shadowpho/Chalk-Bot/README

Chalk robot.

--Root\
	Docs\
	Code\
	Hardware\
	Software\
