shadowpho/Chalk-Bot/Docs/Presentation/Final1.pptx

ECE 445 Group 1
December 2, 2011
George Karavaev – Alex Suchko

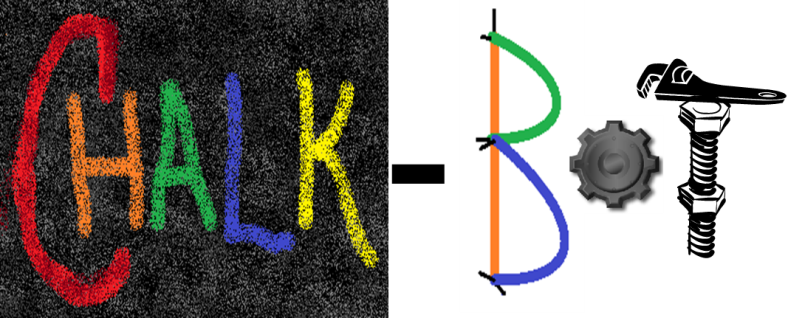
[picture p21: figure]

## Introduction

- ChalkBot is a semi-autonomous chalk drawing system.
- Produces vector graphics.
- Uses common, off the shelf sidewalk chalk.

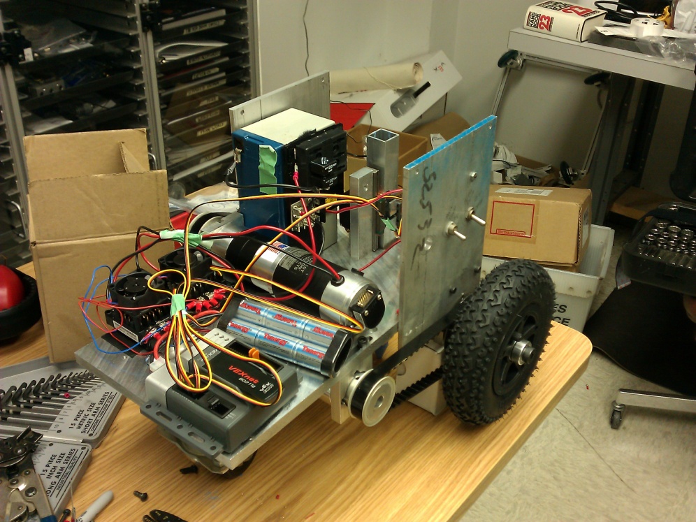
[picture p22: figure]

## Outline

- Mechanical Platform
  - GoBot Base and Chalk Feed
- Electronics System
  - Overview
  - Power Supply Subsystem
  - Dynamics Control Subsystem
  - High Level Control
- Software
  - Reset Sequencing and Supervision
  - Dynamics and Body Control
  - High Level Interface and Directive Control

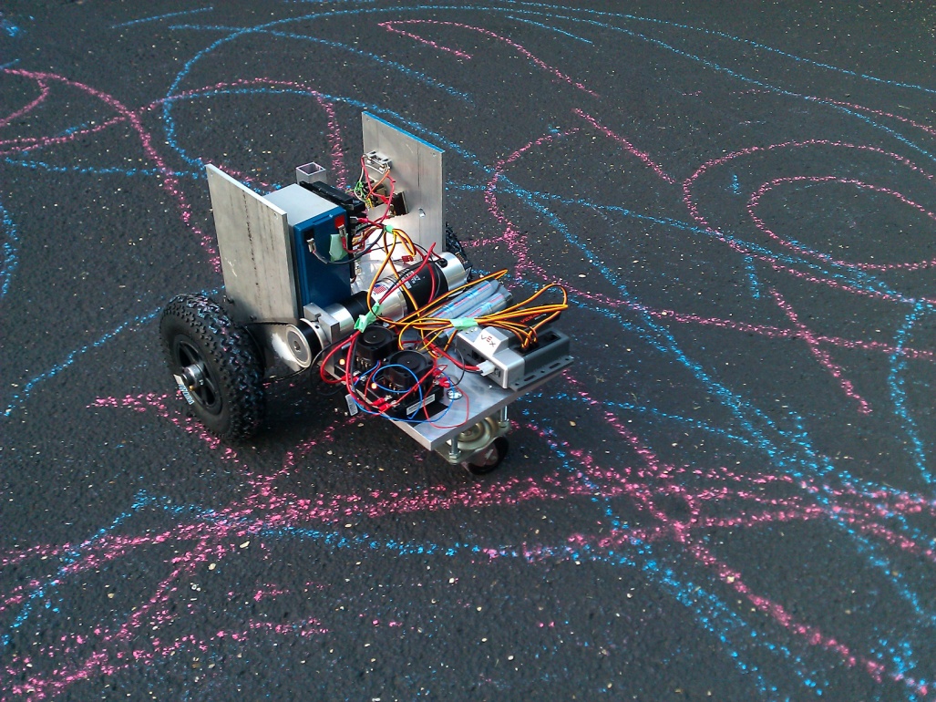
[picture p23: figure]

## Mechanical Platform

## Mechanical Platform\\ GoBot Base and Chalk Feed

- Two brushed drive motors, coupled to rear drive tires via synchronous belt.
- Forward idler ‘caster’ wheel.
- Rear mounted chalk feed mechanism, actuated by two positioning servo-motors.
- One 12VDC nominal sealed lead-acid battery.

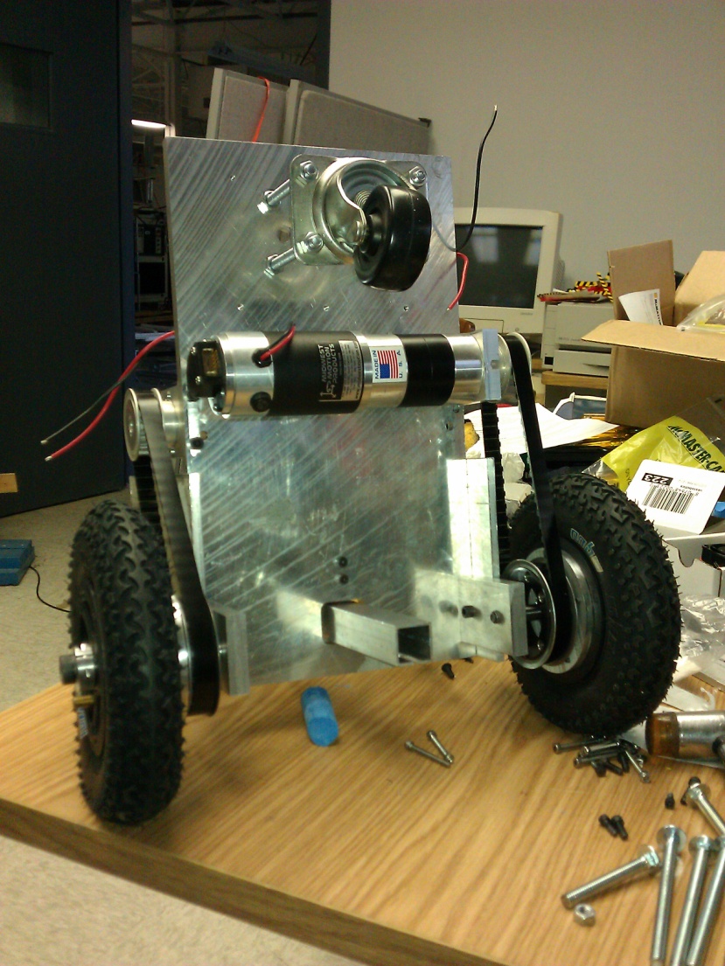
[picture p24: figure]

## Electronics System\\ Overview

## Special Thanks\\

- Mark Smart
- Skot Wiedmann
- Dan Mast
- Adam Suchko
- Mikhail Karavaev
- Kaitlin Minogue
- Jane Tu
- Tom Engibous (TI)

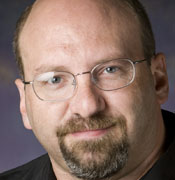
[picture p25: figure]
Mark Wayne Smart
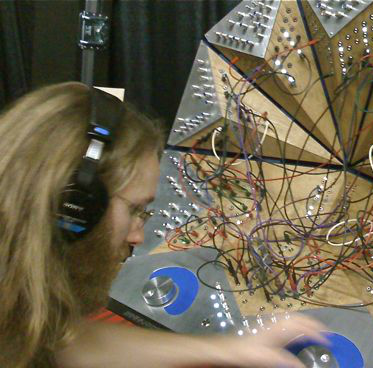
[picture p26: figure]
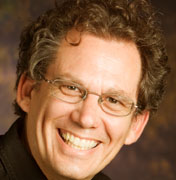
[picture p27: figure]
Daniel E. Mast
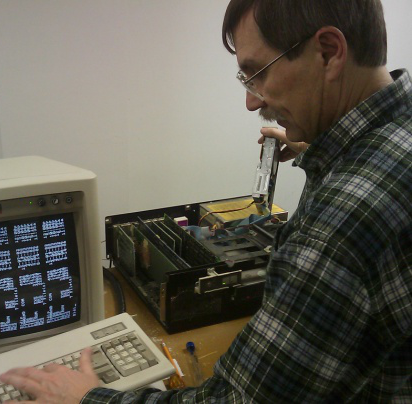
[picture p28: figure]
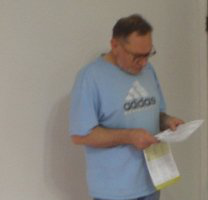
[picture p29: figure]
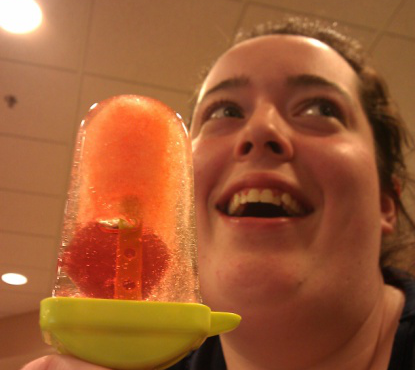
[picture p30: figure]
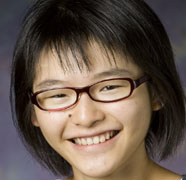
[picture p31: figure]
Jane S. Tu
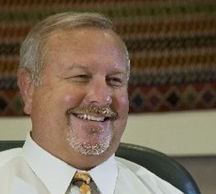
[picture p32: figure]

From top left: University of Illinois, TJ for Califaudio, University of Illinois, Alex Suchko, George Karavaev, Alex Suchko, University of Illinois, Brandon Wade for The Chronicle
