shadowpho/Chalk-Bot/Docs/Presentation/Mock1.pptx

ECE 445 Group 1
November 7, 2011
George Karavaev – Alex Suchko

don’t forget to credit Kaitlin for the ChalkBot logo


## Introduction

- ChalkBot is a semi-autonomous chalk drawing system.
- Produces vector graphics.
- Uses common, off the shelf sidewalk chalk.


## Outline

- Mechanical Platform
  - GoBot Base and Chalk Feed
- Electronics System
  - Overview
  - Power Supply Subsystem
  - Dynamics Control Subsystem
  - High Level Control
- Software
  - Reset Sequencing and Supervision
  - Dynamics and Body Control
  - High Level Interface and Directive Control


## Mechanical Platform\\ GoBot Base and Chalk Feed

- Two brushed drive motors, coupled to rear drive tires via synchronous belt.
- Forward idler ‘caster’ wheel.
- Rear mounted chalk feed mechanism, actuated by two positioning servo-motors.
- One 12VDC nominal sealed lead-acid battery.


## Electronics System\\ Overview
