shadowpho/Chalk-Bot/Docs/DesignReview/dtsheets/cb01_typical.png

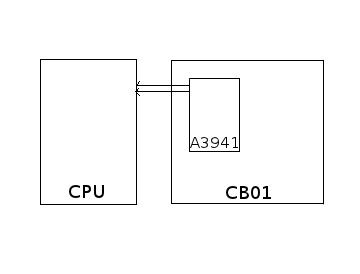
Docs/DesignReview/dtsheets/cb01_typical.png
