shadowpho/Chalk-Bot/Docs/DesignReview/ece445_general.png

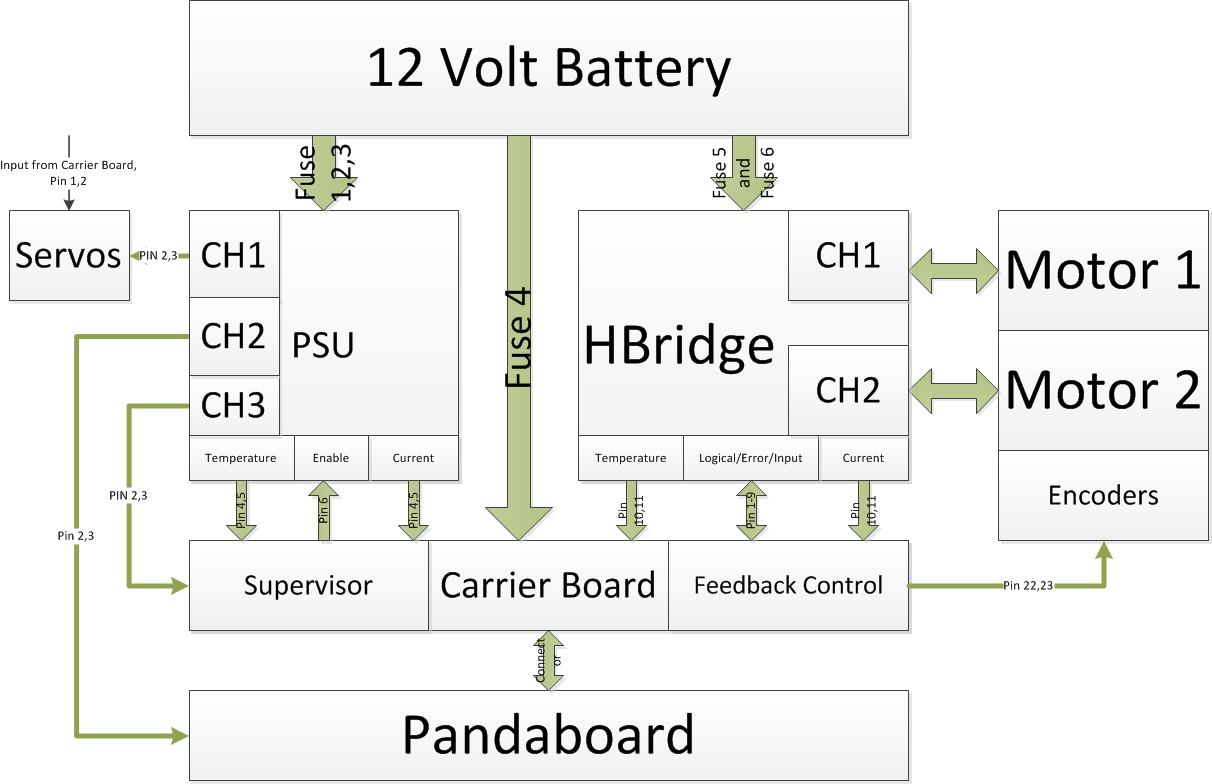
Docs/DesignReview/ece445_general.png
