shadowpho/Chalk-Bot/Docs/ProgressReport/ECE 445 Carrier board milling.jpg

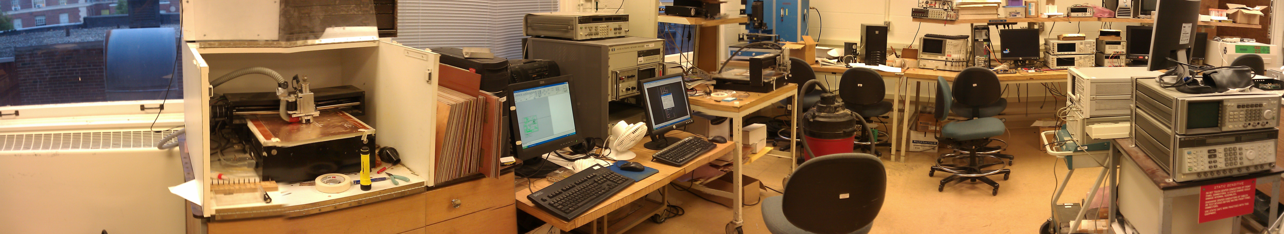
Docs/ProgressReport/ECE 445 Carrier board milling.jpg
