shadowpho/Chalk-Bot/Docs/ProgressReport/ECE 445 Lab 10_25_2011.jpg

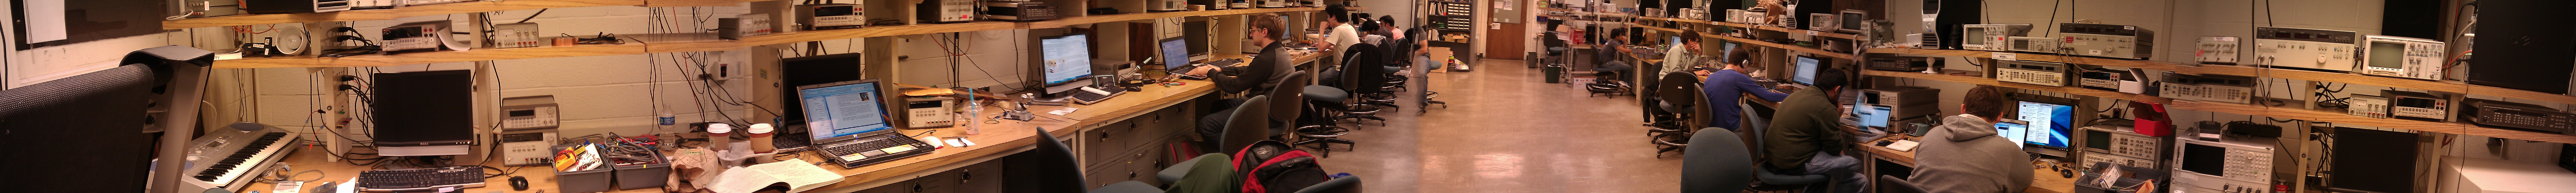
Docs/ProgressReport/ECE 445 Lab 10_25_2011.jpg
