shadowpho/Chalk-Bot/Docs/BOM_1.xlsx

Type | Value | Package | Quantity | Orderable P/N
capacitor | 0.1 uF | 603 | 5
capacitor | 0.1 uF | 1206 | 4
capacitor | 1.0 uF | 603 | 2
capacitor | 1.0 uF | 1206 | 2
capacitor | 5.0 uF | 1206 | 1
capacitor | 150 pF | 603 | 1
capacitor | 22 uF | CAP_POLPTH2 | 3 |  | c special
capacitor | 22 uF | 1206 | 1
capacitor | 2.2 uF | 603 | 3
capacitor | 3.6 pF | 603 | 1
current_sensor | INA226 | PSOP-10 | 2
inductor | NR10050T220M | NR10050 | 1
ldo | MIC5235 | SOT23-5 | 1
led |  | 805 | 2
nfet | IRFML8244 | SOT23 | 1
pfet | IRF9317 | SOIC8 | 1
pin_header | 68000-216HLF |  | 2
resistor | 0 ohm | 805 | 4
resistor | 1 ohm | 603 | 4
resistor | 1.3 kohm | 805 | 1
resistor | 10 kohm | 805 | 1 | 1792016
resistor | 150 kohm | 805 | 1
resistor | 19.62 kohm | 805 | 1 | 1753437
resistor | 3.74 kohm | 805 | 2
resistor | 10 mohm | 805 | 1
resistor | 40 mohm | 1206 | 1
resistor | 5.1 kohm | 805 | 6
resistor | 30 kohm | 805 | 1
screw_terminals | 1792016 |  | 3
smps | NCP3155A | SOIC8 | 1
socket | 1753437 |  | 3
temperature_sensor | TMP100 | PSOP-6 | 1
bridge_driver | A3941 | TSOP28 | 1
nfet | STP60N3LH5 | TO-220 | 4 |  | avnet
connector | 7693K-ND |  | 2
