shadowpho/Chalk-Bot/Software/motion/boards/ek-lm4f232/motion/flashstore.c

//*****************************************************************************
//
// flashstore.c - Data logger module to handle storage in flash.
//
// Copyright (c) 2011 Texas Instruments Incorporated.  All rights reserved.
// Software License Agreement
// 
// Texas Instruments (TI) is supplying this software for use solely and
// exclusively on TI's microcontroller products. The software is owned by
// TI and/or its suppliers, and is protected under applicable copyright
// laws. You may not combine this software with "viral" open-source
// software in order to form a larger program.
// 
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
// This is part of revision 8049 of the EK-LM4F232 Firmware Package.
//
//*****************************************************************************

#include <string.h>
#include "inc/hw_types.h"
#include "driverlib/debug.h"
#include "driverlib/flash.h"
#include "utils/ustdlib.h"
#include "motion.h"                 // prior to 11/10/2011, was qs-logger.h
#include "usbstick.h"
#include "flashstore.h"

//*****************************************************************************
//
// This module manages the storage of data logger data into flash memory.
//
//*****************************************************************************

//*****************************************************************************
//
// Define the beginning and end of the flash storage area.  You must make sure
// that this area is well clear of any space occupied by the application
// binary, and that this space is not used for any other purpose.
// The start and end addresses must be 1K aligned.  The end address is
// exclusive - it is 1 value greater than the last valid location used for
// storage.
//
//*****************************************************************************
#define FLASH_STORE_START_ADDR 0x20000
#define FLASH_STORE_END_ADDR 0x40000

//*****************************************************************************
//
// The next address in flash, that will be used for storing a data record.
//
//*****************************************************************************
static unsigned long g_ulStoreAddr;

//*****************************************************************************
//
// A buffer used to assemble a complete record of data prior to storing it
// in the flash.
//
//*****************************************************************************
static unsigned long g_ulRecordBuf[32];

//*****************************************************************************
//
// Initializes the flash storage. This is a stub because there is nothing
// special to do.
//
//*****************************************************************************
void
FlashStoreInit(void)
{
}

//*****************************************************************************
//
// Saves data records that are stored in the flash to an externally connected
// USB memory storage device (USB stick).
// The flash memory is scanned for the presence of store data records.  When
// records are found they are written in CSV format to the USB stick.  This
// function assumes a non-corrupted storage area, and that any records, once
// found, are contiguous with all stored records.  It will find the oldest
// record and start with that when storing.
//
//*****************************************************************************
int
FlashStoreSave(void)
{
    unsigned long ulAddr;
    unsigned long ulOldestRecord = FLASH_STORE_START_ADDR;
    unsigned long ulOldestSeconds = 0xFFFFFFFF;
    tLogRecord *pRecord;

    //
    // Show a message to the user.
    //
    SetStatusText("SAVE", "SCANNING", "FLASH", 0);

    //
    // Start at beginning of flash storage area
    //
    ulAddr = FLASH_STORE_START_ADDR;

    //
    // Search all of flash area checking every stored record.
    //
    while(ulAddr < FLASH_STORE_END_ADDR)
    {
        //
        // If a record signature is found, check for oldest record, then
        // increment to the next record
        //
        if((HWREG(ulAddr) & 0xFFFFFF00) == 0x53554100)
        {
            //
            // Get a pointer to the data record (account for flash header word)
            //
            pRecord = (tLogRecord *)(ulAddr + 4);

            //
            // If the seconds in this record are older than any found so far
            // then save the seconds value, and the address of this record
            //
            if(pRecord->ulSeconds < ulOldestSeconds)
            {
                ulOldestSeconds = pRecord->ulSeconds;
                ulOldestRecord = ulAddr;
            }

            //
            // Advance the address to the next record.
            //
            ulAddr += HWREG(ulAddr) & 0xFF;
        }

        //
        // Otherwise a record was not found so just advance to the next
        // location in flash
        //
        else
        {
            ulAddr += 4;
        }
    }

    //
    // If no "oldest" seconds was found, then there is no valid data stored
    //
    if(ulOldestSeconds == 0xFFFFFFFF)
    {
        SetStatusText("SAVE", "NO RECORDS", "FOUND", "PRESS <");
        return(1);
    }

    //
    // Open the output file on the USB stick.  It will return NULL if there
    // was any problem.
    //
    if(!USBStickOpenLogFile(0))
    {
        SetStatusText("SAVE", 0, "USB ERROR", "PRESS <");
        return(1);
    }

    //
    // Notify user we are saving data to USB
    //
    SetStatusText("SAVE", "SAVING", "TO USB", 0);

    //
    // Start reading records from flash, start at the address of the oldest
    // record, as found above.  We scan through records, assuming the flash
    // store is not corrupted.  Continue scanning until a blank space is
    // found which should indicate the end of recorded data, or until we
    // have read all the records.
    //
    ulAddr = ulOldestRecord;
    while(HWREG(ulAddr) != 0xFFFFFFFF)
    {
        unsigned long ulCount;
        unsigned long ulPartialCount;

        //
        // If a record signature is found (which it should be), extract the
        // record data and send it to USB stick.
        //
        if((HWREG(ulAddr) & 0xFFFFFF00) == 0x53554100)
        {
            //
            // Get byte count for this record
            //
            ulCount = HWREG(ulAddr) & 0xFF;

            //
            // Adjust the count and the address to remove the flash header
            //
            ulCount -= 4;
            ulAddr += 4;

            //
            // Adjust for memory wrap
            //
            if(ulAddr >= FLASH_STORE_END_ADDR)
            {
                ulAddr = FLASH_STORE_START_ADDR;
            }

            //
            // If the contents of this record go past the end of the memory
            // storage area, then perform a partial copy first.
            //
            ulPartialCount = 0;
            if((ulAddr + ulCount) >= FLASH_STORE_END_ADDR)
            {
                //
                // Find how many bytes are left on this page
                //
                ulPartialCount = FLASH_STORE_END_ADDR - ulAddr;

                //
                // Copy the portion until the end of memory store, adjust
                // remaining count and address
                //
                memcpy(g_ulRecordBuf, (void *)ulAddr, ulPartialCount);
                ulCount -= ulPartialCount;
                ulAddr = FLASH_STORE_START_ADDR;
            }

            //
            // Copy entire record (or remaining part of record if memory wrap)
            // into record buffer
            //
            memcpy(&g_ulRecordBuf[ulPartialCount / 4], (void *)ulAddr,
                   ulCount);

            //
            // Update address pointer to next record
            //
            ulAddr += ulCount;

            //
            // Now we have an entire data logger record copied from flash
            // storage into a local (contiguous) memory buffer.  Pass it
            // to the USB file writing function to write the record to the
            // USB stick.
            //
            USBStickWriteRecord((tLogRecord *)g_ulRecordBuf);
        }

        //
        // This should not happen, but it means we ended up in a non-blank
        // location that is not the start of a record.  In this case just
        // advance through memory until either a blank location or another
        // record is found.
        //
        else
        {
            //
            // Increment to next word in flash, adjust for memory wrap.
            //
            ulAddr += 4;
            if(ulAddr >= FLASH_STORE_END_ADDR)
            {
                ulAddr = FLASH_STORE_START_ADDR;
            }
        }
    }

    //
    // Close the USB stick file so that any buffers will be flushed.
    //
    USBStickCloseFile();

    //
    // Inform user that save is complete.
    //
    SetStatusText("SAVE", "USB SAVE", "COMPLETE", "PRESS <");

    //
    // Return success
    //
    return(0);
}

//*****************************************************************************
//
// This is called at the start of logging to prepare space in flash for
// storage of logged data.  It searches for the first blank area in the
// flash storage to be used for storing records.
//
// If a starting address is specified then the search is skipped and it goes
// directly to the new address.  If the starting address is 0, then it performs
// the search.
//
//*****************************************************************************
int
FlashStoreOpenLogFile(unsigned long ulStartAddr)
{
    unsigned long ulAddr;

    //
    // If a valid starting address is specified, then just use that and skip
    // the search below.
    //
    if((ulStartAddr >= FLASH_STORE_START_ADDR) &&
       (ulStartAddr < FLASH_STORE_END_ADDR))
    {
        g_ulStoreAddr = ulStartAddr;
        return(0);
    }

    //
    // Start at beginning of flash storage area
    //
    ulAddr = FLASH_STORE_START_ADDR;

    //
    // Search until a blank is found or the end of flash storage area
    //
    while((HWREG(ulAddr) != 0xFFFFFFFF) && (ulAddr < FLASH_STORE_END_ADDR))
    {
        //
        // If a record signature is found, then increment to the next record
        //
        if((HWREG(ulAddr) & 0xFFFFFF00) == 0x53554100)
        {
            ulAddr += HWREG(ulAddr) & 0xFF;
        }

        //
        // Otherwise just advance to the next location in flash
        //
        else
        {
            ulAddr += 4;
        }
    }

    //
    // If we are at the end of flash that means no blank area was found.
    // So reset to the beginning and erase the first page.
    //
    if(ulAddr >= FLASH_STORE_END_ADDR)
    {
        ulAddr = FLASH_STORE_START_ADDR;
        FlashErase(ulAddr);
    }

    //
    // When we reach here we either found a blank location, or made a new
    // blank location by erasing the first page.
    // To keep things simple we are making an assumption that the flash store
    // is not corrupted and that the first blank location implies the start
    // of a blank area suitable for storing data records.
    //
    g_ulStoreAddr = ulAddr;

    //
    // Return success indication to caller
    //
    return(0);
}
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
