shadowpho/Chalk-Bot/Software/motion/boards/ek-lm4f232/motion/images.c

//*****************************************************************************
//
// images.c - Data for images used in the user interface.
//
// Copyright (c) 2008-2011 Texas Instruments Incorporated.  All rights reserved.
// Software License Agreement
// 
// Texas Instruments (TI) is supplying this software for use solely and
// exclusively on TI's microcontroller products. The software is owned by
// TI and/or its suppliers, and is protected under applicable copyright
// laws. You may not combine this software with "viral" open-source
// software in order to form a larger program.
// 
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
// This is part of revision 8049 of the EK-LM4F232 Firmware Package.
//
//*****************************************************************************

#include "grlib/grlib.h"

//*****************************************************************************
//
// This image contains the TI logo with black background.
//
//*****************************************************************************
const unsigned char g_pucImage_TI_Black[] =
{
    IMAGE_FMT_4BPP_COMP,
    96, 0,
    64, 0,

    15,
    0x00, 0x00, 0x00,
    0x11, 0x11, 0x15,
    0x0d, 0x0a, 0x55,
    0x2d, 0x2d, 0x2d,
    0x18, 0x13, 0xa1,
    0x4c, 0x4c, 0x4c,
    0x23, 0x1c, 0xea,
    0x6b, 0x6b, 0x6b,
    0x87, 0x87, 0x87,
    0x9b, 0x9b, 0x9b,
    0xa8, 0xa8, 0xa8,
    0xb9, 0xb9, 0xb9,
    0xc8, 0xc8, 0xc8,
    0xd7, 0xd7, 0xd7,
    0xe6, 0xe6, 0xe6,
    0xfe, 0xfe, 0xfe,

    0xff, 0x07, 0x07, 0x07, 0x07, 0x07, 0x07, 0x07, 0x07, 0xff, 0x07, 0x07,
    0x07, 0x07, 0x07, 0x07, 0x07, 0x07, 0xff, 0x07, 0x07, 0x07, 0x07, 0x07,
    0x07, 0x07, 0x07, 0xff, 0x07, 0x07, 0x07, 0x07, 0x07, 0x07, 0x07, 0x07,
    0xff, 0x07, 0x07, 0x07, 0x07, 0x07, 0x07, 0x07, 0x07, 0xff, 0x07, 0x07,
    0x07, 0x07, 0x07, 0x07, 0x07, 0x07, 0xff, 0x07, 0x07, 0x07, 0x07, 0x07,
    0x07, 0x07, 0x07, 0xff, 0x07, 0x07, 0x07, 0x07, 0x07, 0x07, 0x07, 0x07,
    0xff, 0x07, 0x07, 0x07, 0x07, 0x07, 0x07, 0x07, 0x07, 0xff, 0x07, 0x07,
    0x07, 0x07, 0x07, 0x07, 0x07, 0x07, 0xff, 0x07, 0x07, 0x07, 0x07, 0x07,
    0x07, 0x07, 0x07, 0xff, 0x07, 0x07, 0x07, 0x07, 0x07, 0x07, 0x07, 0x07,
    0xff, 0x07, 0x07, 0x07, 0x07, 0x07, 0x07, 0x07, 0x07, 0xff, 0x07, 0x07,
    0x07, 0x07, 0x07, 0x07, 0x07, 0x07, 0x8f, 0x03, 0x44, 0x44, 0x20, 0x07,
    0x07, 0x77, 0x2f, 0x83, 0x07, 0x66, 0x66, 0x20, 0x02, 0x10, 0x07, 0x07,
    0xe0, 0x77, 0x2f, 0x05, 0x66, 0x66, 0x20, 0x26, 0x20, 0xf8, 0x07, 0x07,
    0x77, 0x2f, 0x05, 0x66, 0x66, 0x20, 0x2f, 0x24, 0x10, 0x03, 0x01, 0x07,
    0x07, 0x77, 0x2f, 0x00, 0x00, 0x66, 0x66, 0x62, 0x24, 0x14, 0x44, 0x20,
    0x07, 0x00, 0x7d, 0xbc, 0xcb, 0xc1, 0x07, 0x07, 0x77, 0x80, 0x2f, 0x66,
    0x66, 0x62, 0x64, 0x26, 0x66, 0x40, 0x00, 0x00, 0x75, 0x3f, 0xc3, 0x85,
    0x33, 0x01, 0x31, 0x01, 0x00, 0x31, 0x00, 0x10, 0x00, 0x05, 0x10, 0x07,
    0xc0, 0xbf, 0x76, 0x66, 0x66, 0x22, 0x64, 0x14, 0x66, 0x00, 0x20, 0x00,
    0x00, 0x0f, 0x90, 0x7e, 0xaa, 0x95, 0x00, 0xfd, 0x08, 0xe3, 0x0a, 0xf1,
    0x03, 0xba, 0xc8, 0xe0, 0x07, 0xbf, 0x73, 0x22, 0x22, 0x22, 0x66, 0x62,
    0x00, 0x02, 0x62, 0x02, 0x66, 0x40, 0x00, 0x00, 0x0f, 0x00, 0x90, 0x8f,
    0x00, 0x50, 0x7f, 0x5a, 0x30, 0x3c, 0x0e, 0xf9, 0x0c, 0xf0, 0x05, 0x05,
    0xcd, 0x97, 0x46, 0x00, 0x66, 0x66, 0x66, 0x64, 0x12, 0x62, 0x24, 0x66,
    0x00, 0x62, 0x00, 0x00, 0x0f, 0x90, 0x7f, 0x8a, 0x70, 0x00, 0x0a, 0xf3,
    0x00, 0x85, 0x5f, 0x05, 0xff, 0xb3, 0xe0, 0x05, 0xcd, 0x97, 0x02, 0x66,
    0x66, 0x66, 0x66, 0x00, 0x24, 0x62, 0x66, 0x66, 0x64, 0x00, 0x00, 0x0f,
    0x00, 0x90, 0x8f, 0x57, 0x30, 0x08, 0xf9, 0x00, 0xd8, 0x07, 0x8f, 0x50,
    0x18, 0xdf, 0x30, 0x04, 0xd4, 0xa7, 0x00, 0x00, 0x00, 0x26, 0x66, 0x66,
    0x66, 0x26, 0x42, 0x00, 0x66, 0x66, 0x64, 0x00, 0x00, 0x0f, 0xa0, 0x8f,
    0x00, 0x00, 0x31, 0x88, 0x3f, 0x73, 0xc7, 0x7e, 0xc7, 0x1c, 0x50, 0x1f,
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
