shadowpho/Chalk-Bot/(commit log)

2011-05-01 Added initial revision of the test power board.
    This power board has a screen, a processor, and a +5v line. Testin!
    [board_1.brd, board_1.sch]
2011-05-02 Added a shunt current measuring resistor.
    *Library modified to add the current sense op-amp. We will use a gain of 50.
    *schematics added.
    [board_1.brd, board_1.sch]
2011-05-03 Added our proposal to repositary.
    *Need to remove sensor part
    *Need block diagrams of systems interacring with each other.
    *Need more diagrams.
2011-05-03 Fixed the switch to the PSU. Several name changes.
    *We now have a main pfet driver for each rail of psu. The pfet is turned off by nfet, and is turned on by the pullup resistor. I am slightly worried about clean turn on of the whole thing, but I am hoping the nfet will turn on sooner then pfet. We need math to the rescue!
    *Did several naming changes to wires and cheaps to more cleanly describe what they do.
    *Added second programming header jumper. Now we have ADC of 2 current sensors and 2 voltages [input /4, output /2].
    *Started routing. Electra showed it's possible. So now doing it all by hand. Expecting 50 vias or so. [so an hour of it].
    [board_1.brd, board_1.sch]
2011-05-04 Board routed + Schematics has 2 fixes.
    *Schematics
    +Changed the +5V to VCC with a value of 5V. This fixed it complaining.
    +Added ground to ACS712 [oops...]
    Board.
    +Hand-routed power supply.
    +Hand-routed everything past first fet
    *Automatic routing for connections to screen
    +Moved routes from under the chips
    +Did checks to make sure spacing is good. Screen is pretty tight, everything else is good.
    +About 40 vias total.
    [board_1.brd, board_1.sch]
2011-05-08 *Added in/out capacitors, redid board, fixd induc.
    Schematics:
    *The switching PS requires a big [22 uF] capacitor on the input line in addition to the ceramic [0.1 uF] one. So, I added it. In addition, I added an output one as same reasoning applies.
    Board:
    *Redid the board as 4:2 in instead of 2:2. Our final board will be 4x4, so this way we can adjust to 4:1 for every PS voltage.
    *The inductor has a bigger body then the soldering pads [thanks Alex!]. Fixed. Changed the library, and made clearance.
    *Added the caps described above.
    [board_1.brd, board_1.sch]
2011-05-08 Made wires thicker and moved a wire.
    *Oops, one of the wires from out capacitor to shunt resistor was a little too thin. Changed to 40 mils. Now, all current carrying wires are 40 mils.
    *Moved the via away from inductor.
    Also, we have a minimum of 10 mils clearance!
    [board_1.brd]
2011-08-28 Added A3941 part, and made a new schematic.
    A3941 - best Hbridge controller I found. Power works out for us not to have any fans anywhere.
    Schematic now contains one motor. However, I am currently decided which of the two mosfets to use [one has a higher Rdson, one has a higher Qgc]
    Need to figure out how to control steppers.
    [schem1.sch]
2011-08-29 First approximation of 1 ch full bridge routing.
    *Schematic - added test points.
    *Board - routed out. I approximate about 2x2 inches to route each channel on 2 layer board. Minimum vias required.
    NOTICE: No heating layers out yet.
    No care taken to separate grounds yet.
    Not connecting pins to correct places yet.
    Might want to use smaller parts. [please?]
    Might change mosfets. This will cut on space.
    [schem1.brd, schem1.sch]
2011-09-04 Fixed library A3941, test Hbridge schematics/board.
    *Changed the outline of A3941 in library from 21 to 51. This tells the eagle not to place any parts inside A3941, but vias are good.
    *schematics changed grounds to be more separated.
    *Board made changed to ground and added planes. "Loud" ground goes directly to negative battery terminal.
    [schem1.brd, schem1.sch]
2011-09-05 Enlarged traces on H-Bridge
    Current carrying lines for H-Bridge widened to reduce resistive loss, moved
    some traces as well to accomodate widened trace widths.
    [schem1.brd, schem1.sch]
2011-09-05 Added INA226 [current sensor] to library.
    Contains package, device, footprint.
2011-09-05 Added INA226 to schematic/board.
    INA226 = ti chip op amp i2c for shunt resistor current measurment.
    Schematic - has filter cap + 2 resistors
    Board - one of the address line must be soldered by hand to select address.
    [schem1.brd, schem1.sch]
2011-09-05 Added a 10 pin header instead of random pins.
    Had to move a HUGE number of parts around. Now we have spare space on the right!
    [schem1.brd, schem1.sch]
2011-09-05 Added screw terminals + screw terminals. Routed.
    Holy shit.
    *Screw terminals for motor at 5x7 mm. That is a THIRD of the size of sides. This means that we are runnign out of space hard. routing those signals is a mirace now.
    *Screw terminals for +12v might stick out the side a bit. Shouldn't be a big deal as long as we don't put too much weight on it.
    *silkscreen not done yet.
    [schem1.brd, schem1.sch]
2011-09-05 Silkscreen complet for board.
    Not the best silkscreen i've done, but it's 5 am.
    [schem1.brd, schem1.sch]
2011-09-05 FINAL VERSION, ABOUT TO GO OUT.
    Changed a couple wires after looking at gerber results.
    [schem1.brd]
2011-09-06 Small PSU generated. Schematic + board.
    Features:
    *12V in, 5v out.
    *2 LEDs, one for power connected to input, 1 for power output is on.
    *4 pin control [I2c, enable, Alert]
    *Features current measurment just like HBridge!
    *Very suitable 1.2x1.7 in package!
    *Uses same connectors as HBridge. [because we will mostly use this PSU for servos.
    Does NOT feature:
    *Fixed silkscreen
    *Thermal measurment.
    *Proper width for all current carrying wires.
    *Proper calculation on required current for ENABLE pin.
    *Did NOT fix pfet to nfet to enable our Pfet.
    *New components for PSU to operate at 10-15 instead of 18-25. It will work, but not optimally.
    [board_1.brd]
2011-09-06 Oops, this should go with last commit.
    [board_1.sch]
2011-09-08 Added TMP100, fixed silkscreen on power board.
    Library contains a TMP100 temp sensor. It didn't fit on the Hbridge part though :(.
    [board_1.brd, board_1.sch, schem1.brd]
2011-09-08 Fixed an isse with address selection of TMP100
    The wires could've been silkscreened, preventing soldering. Added smd tabs to prevent that.
    [board_1.brd]
2011-09-09 Missed this file. I should learn amend :(`
    [board_1.sch]
2011-09-11 Fixed doc links.
    [Parts.xls]
2011-09-13 Proposal fixed, 'cept for BOM.
2011-09-14 Ver 1.0. Has list of figures and BOM calculated.
2011-09-16 Added 9A PSU. Modified values for HBridge.
    So I remembered that we have a bunch of NPC3030 parts I ordered together with NPC3155. They are very similar, but have external switches(yay!). Therefore we can do 9amperes. The only problem is that we need 2 pfets [so ea has a heat dissipation of 0.35W instead of 0.7W.
    [schem1.sch, untitled.brd, untitled.sch]
2011-09-17 Finished calculating values for HBridges. BOM.
    [schem1.sch]
2011-09-17 Added 22 uF cap to input.
    [schem1.sch]
2011-09-17 BOM, and updated from alex.
    [BOM_1.xlsx, board_1.sch]
2011-09-27 commiting carrier board + WASTE FILES.
    [carrier.sch]
2011-10-03 Re-did board+schematic for Hbridge.
    *separated ground layers. Now quiet comes in from pin 12
    *added huuuge capacitor.
    *changed footprint for current sensor
    *changed how you change address for current sensor.
    *changed shunt R to 1206
    *MOSFETS now have catch diodes and scrubber caps.
    *more test vias. WOOHOO
    [schem1.brd, schem1.sch]
2011-10-12 Added schematic/part for two dev boards.
    Bad sizment for cortex-m4 board, need to measure size.
2011-10-17 Library now contains footprints for carrier board.
    *Power supply
    *Hbrirdge
    *Pandaboard.
2011-10-17 Library updated. Carrier design started.
    PCA9306 added, plus TI SN part for pin extanders.
    Carrier board kinda large.
    [carrier.brd, carrier.sch]
2011-10-17 Did some schematic work
    Added hardware for ultrasonic, chalk switch, servo pwm, all but i2c for hbridges, still needs qei maybe something else I forgot. (-Alex)
    [carrier.brd, carrier.sch]
2011-10-18 Carrier board schematic theoretically finished.
    Added 2x QEI interfaces, IMU interface, 5v I2C support for H-bridge power monitor ICs, pull-up for ALERT pin, 2ch of auxilliary PWMable low side power n-fet drives with zener diodes for high positive voltage transient suppression (i.e. low-side drive of an inductive load).
    [carrier.brd, carrier.sch]
2011-10-21 alex did lots of work on carrier routing.
    [carrier.brd, carrier.sch]
2011-10-23 Voltage supervisor portion of carrier board done.
    *Removed I2C and SPI. Only UART + 3 GPIOs remaining.
    [carrier.brd, carrier.sch]
2011-10-24 Alex added his parts. Done.
    [carrier.brd, carrier.sch]
2011-10-25 Modified to have Cy8kit to fit with HBridge.
    Sent to production.
    [carrier.brd]
2011-11-01 Git v2 of carrier board sent to Mark
    [carrier.brd]
2011-11-14 Got PWM to work! Has simple demo of PWM out.
    At this time, noticed that on carrier board PWM output level translator was
    soldered shifted one pin space to the right due to visually confusing board
    geometry (a trace looked like a pad).
2011-11-15 Wrote in work around for PD7 dead pin.
    Jumpered PF2 over, it now serves the function PD7 once did. Successful PWM
    demo using H-Bridge! Need to handle fault conditions.
2011-11-16 Implemented support for SVM_1 and SVM_2.
    PWM output implemented and tested functional for SVM_1 and SVM_2 outputs.
    Period is ~60Hz, measured as ~59.99Hz, ~16.67ms.on Agilent 54642A
    oscilloscope.
2011-11-16 Implemented SVM load interrupt, possible off by 1.
    Implemented first interrupt on this part. Good example of exactly this in
    StellarisWare. Tested by toggling reset line on 'left' hbridge port. Found
    period to be slightly off, 59.9126Hz instead of ideal ~60Hz. Careful! I just
    remembered I left a decremented-by-one reload value in for SVM, I was
    starting to tune. Bear this in mind when studying reload value.
    [motion.c, startup_ewarm.c, svm.c, svm.h]
2011-11-21 Backup version of HBRidge.
    Schematics + Board.
    [untitled.brd, untitled.sch]
2011-11-21 Developed support for QEI, made hardware fixes.
    Developed basic software support for QEI, gets hardware running, may want an
    accessor function or two especially for speed so that the sign of the
    velocity is included. While testing hardware found that PF0 was blown out,
    likely ESD. Used PD6 as backup, used for PWML for hbridge_right. If want
    that pin back, will have to cut trace and jumper another pin over to provide
    this function.
    [encoder.c, encoder.h, hbridge.c, motion.c, startup_ewarm.c, svm.c]
2011-11-22 Added functions to API for QEI.
    Functions compile but were not tested. Functions added to QEI ("encoder.c")
    API:
    >enc_dir_reverse
    >enc_pos_get
    >enc_pos_set
    >enc_vel_get
2011-11-22 Started coding IMU interface.
    I2C should be initialized in master mode, ready to transmit. Next figure out
    how to transmit and receive. Then, figure out register reads, writes to
    perform most importantly to gyroscope to setup and read z-axis.
2011-11-24 Finished coding I2C driver, about to change.
    Finished writing driver for I2C hardware, found that overarching ST protocol
    to communicate with sensors is more complicated than expected. Will need to
    modify code to acommodate multiple starts, internal addresses in part. This
    code was not test run as hardware would not have communicated well with it,
    except in a select case or few.
2011-11-24 Started debugging IMU code. SCL held low problem.
    When I2C1 is reset, SDA and SCL both go high as the bus is idle.
    Unfortunately, once the master function is enabled in the I2C1 module, SCL
    goes low. Have not found solution yet. Will work on this about 1/2hr more
    while off campus then move on to next thing, USB communication.
    [imu.c, motion.c]
2011-11-27 Started work on chalk mechanism, I2C still no.
    Code wasn't compiled yet. Stopped to work with H-bridges so haven't given
    much time to I2C since back. Started work on chalk mechanism controller
    software.
2011-11-28 Finally have I2C running for IMU, using softi2c.
    Using softi2c software library for emulating hardware I2C, part of the
    StellarisWare package. Got IMU to respond over and over with WHO_AM_I of
    0xD3, correct response. Success! Thank you StellarisWare authors!
    We are making progress. :D
    [chalk.c, chalk.h, encoder.c, hbridge.c, imu.c, imu.h, motion.c, softi2c.c]
2011-11-28 Backup as of final demo. Went ok.
    Current sensing and temp sensing worked on power supply, encoders wouldn't
    enable, chalk servo control in progress, chalk switch not really reading
    right, ultrasonics not implemented, USB comm working, software I2C working,
    gyro interface not well tested.
    Thank God for all the help on this project! I hope we can come back to this
    later.
2011-12-02 Working on final presentation.
    Some parts left as placeholders for George, a couple more for me to write as
    well.
2011-12-06 We have 6 pages with not content. Appendx works.
    Equatiosna are currently removed -- still get listed as figures :/. Grr.
